phon441199/vehicle-gimbal-arm/gimbalarm_hardware_teensypin.txt

gm4108
 mks Dual channel FOC V3.2 Plus: ch1-0 1 2 +3(enable)/ch2-4 5 6+7(enable)/current	sensor1-14 15(analogue)/current sensor2-16 17

 encoder(AS5048A*2)1-9 + 11 12 13/encoder2-10(SPI) + 11 12 13(공통)

ak40 - 10
 CAN transciever(sn65hvd230)- 22(tx) 23(rx)

digital servo
 pwm-8
 
ICM20948(9축IMU)-18(sda) 19(scl)

  GM4108H + MKS DUAL FOC V3.2 Plus + Teensy 4.1 배선 가이드       
                                                                  
  1. GM4108H 모터 → MKS 보드 (모터 스크류 터미널)                 
                                                        
  MKS DUAL FOC 보드에는 M0, M1 두 개의 3상 모터 커넥터(스크류     
  터미널)가 있습니다.                                             
                                                                  
  ┌───────────┬──────────────┬────────────────────────────────┐   
  │   모터    │  MKS 터미널  │              연결              │
  ├───────────┼──────────────┼────────────────────────────────┤   
  │ GM4108H   │ M0 스크류    │ 모터의 3개 상선(A, B, C)을     │
  │ #1        │ 터미널       │ M0의 3핀에 연결                │
  ├───────────┼──────────────┼────────────────────────────────┤   
  │ GM4108H   │ M1 스크류    │ 모터의 3개 상선(A, B, C)을     │
  │ #2        │ 터미널       │ M1의 3핀에 연결                │   
  └───────────┴──────────────┴────────────────────────────────┘
                                                                  
  ▎ 상선 순서(A/B/C)가 바뀌면 모터 회전 방향만 바뀝니다. SimpleFOC
  ▎  initFOC()가 자동 정렬하므로 크게 문제없지만, 일관성 있게 
  ▎ 연결하는 것이 좋습니다.                                       
                                                        
  ---
  2. MKS 보드 ESP32 소켓 헤더 → Teensy 4.1
                                                                  
  MKS 보드는 원래 ESP32 모듈을 꽂는 상단/하단 2열 13핀 헤더가
  있습니다. ESP32 대신 Teensy 4.1에서 점퍼선으로 연결합니다.      
                                                        
  상단 헤더 (13핀, 왼→오로 번호 매김)                             
                                                        
  핀번호:  1    2    3     4     5     6     7     8     9      10
      11   12     13                                              
  기능:   GND   -   PhC1  PhB1  PhA1  PhC0  PhB0  PhA0  Cur1A
  Cur1B  -   Cur0A  Cur0B                                         
                                                        
  하단 헤더 (13핀, 왼→오)                                         
                                                        
  핀번호:  1    2    3-5   6    7    8     9     10    11    12   
  13                                                              
  기능:   EN1  EN0   -    RX   TX   SCL1  SCL0  SDA1  SDA0   -
  3.3V                                                            
                                                        
  ---                                                             
  3. 실제 배선표 (Teensy 핀 → MKS 헤더 핀)              
                                                                  
  모터 0 (펌웨어의 motor1, CH1) — PWM + Enable
                                                                  
  ┌───────────┬─────┬─────────────────┬────────────┐              
  │ Teensy 핀 │  →  │  MKS 헤더 위치  │    기능    │              
  ├───────────┼─────┼─────────────────┼────────────┤              
  │ Pin 0     │ →   │ 상단 8번 (PhA0) │ M0 A상 PWM │    
  ├───────────┼─────┼─────────────────┼────────────┤
  │ Pin 1     │ →   │ 상단 7번 (PhB0) │ M0 B상 PWM │              
  ├───────────┼─────┼─────────────────┼────────────┤              
  │ Pin 2     │ →   │ 상단 6번 (PhC0) │ M0 C상 PWM │              
  ├───────────┼─────┼─────────────────┼────────────┤              
  │ Pin 3     │ →   │ 하단 2번 (EN0)  │ M0 Enable  │    
  └───────────┴─────┴─────────────────┴────────────┘              
   
  모터 1 (펌웨어의 motor2, CH2) — PWM + Enable                    
                                                        
  ┌───────────┬─────┬─────────────────┬────────────┐              
  │ Teensy 핀 │  →  │  MKS 헤더 위치  │    기능    │
  ├───────────┼─────┼─────────────────┼────────────┤              
  │ Pin 4     │ →   │ 상단 5번 (PhA1) │ M1 A상 PWM │    
  ├───────────┼─────┼─────────────────┼────────────┤
  │ Pin 5     │ →   │ 상단 4번 (PhB1) │ M1 B상 PWM │
  ├───────────┼─────┼─────────────────┼────────────┤              
  │ Pin 6     │ →   │ 상단 3번 (PhC1) │ M1 C상 PWM │
  ├───────────┼─────┼─────────────────┼────────────┤              
  │ Pin 7     │ →   │ 하단 1번 (EN1)  │ M1 Enable  │    
  └───────────┴─────┴─────────────────┴────────────┘              
   
  전류센서 (아날로그 입력)                                        
                                                        
  ┌────────────────┬─────┬───────────────────┬─────────────┐      
  │   Teensy 핀    │  →  │   MKS 헤더 위치   │    기능     │
  ├────────────────┼─────┼───────────────────┼─────────────┤      
  │ A0 (물리핀 14) │ →   │ 상단 12번 (Cur0A) │ M0 A상 전류 │
  ├────────────────┼─────┼───────────────────┼─────────────┤
  │ A1 (물리핀 15) │ →   │ 상단 13번 (Cur0B) │ M0 B상 전류 │      
  ├────────────────┼─────┼───────────────────┼─────────────┤      
  │ A2 (물리핀 16) │ →   │ 상단 9번 (Cur1A)  │ M1 A상 전류 │      
  ├────────────────┼─────┼───────────────────┼─────────────┤      
  │ A3 (물리핀 17) │ →   │ 상단 10번 (Cur1B) │ M1 B상 전류 │
  └────────────────┴─────┴───────────────────┴─────────────┘      
                                                        
  GND (필수!)                                                     
   
  ┌──────────┬─────┬─────────────┬────────────────────────────┐   
  │ Teensy   │  →  │  MKS 헤더   │            비고            │
  │    핀    │     │    위치     │                            │   
  ├──────────┼─────┼─────────────┼────────────────────────────┤
  │ GND      │ →   │ 상단 1번    │ Teensy와 MKS 보드의        │   
  │          │     │ (GND)       │ 기준전압 통일              │   
  └──────────┴─────┴─────────────┴────────────────────────────┘
                                                                  
  ---                                                   
  4. 엔코더 AS5048A (SPI) — MKS 보드 아님, 별도 연결
                                                                  
  엔코더는 MKS 보드를 거치지 않고 Teensy에 직접 연결합니다.
                                                                  
  ┌───────────────┬─────┬────────────────┬───────────┐            
  │   Teensy 핀   │  →  │    AS5048A     │   비고    │            
  ├───────────────┼─────┼────────────────┼───────────┤            
  │ Pin 11 (MOSI) │ →   │ 두 엔코더 MOSI │ SPI0 공유 │  
  ├───────────────┼─────┼────────────────┼───────────┤
  │ Pin 12 (MISO) │ →   │ 두 엔코더 MISO │ SPI0 공유 │            
  ├───────────────┼─────┼────────────────┼───────────┤            
  │ Pin 13 (SCK)  │ →   │ 두 엔코더 CLK  │ SPI0 공유 │            
  ├───────────────┼─────┼────────────────┼───────────┤            
  │ Pin 9         │ →   │ 엔코더 #1 CS   │ 칩셀렉트  │  
  ├───────────────┼─────┼────────────────┼───────────┤            
  │ Pin 10        │ →   │ 엔코더 #2 CS   │ 칩셀렉트  │  
  ├───────────────┼─────┼────────────────┼───────────┤            
  │ 3.3V          │ →   │ 두 엔코더 VDD  │           │  
  ├───────────────┼─────┼────────────────┼───────────┤            
  │ GND           │ →   │ 두 엔코더 GND  │           │
  └───────────────┴─────┴────────────────┴───────────┘            
                                                        
  ---
  5. IMU ICM20948 (I2C) — 별도 연결
                                                                  
  ┌──────────────┬─────┬──────────┬───────────────┐
  │  Teensy 핀   │  →  │ ICM20948 │     비고      │               
  ├──────────────┼─────┼──────────┼───────────────┤     
  │ Pin 18 (SDA) │ →   │ SDA      │ Wire 기본 I2C │               
  ├──────────────┼─────┼──────────┼───────────────┤     
  │ Pin 19 (SCL) │ →   │ SCL      │               │               
  ├──────────────┼─────┼──────────┼───────────────┤
  │ 3.3V         │ →   │ VDD      │               │               
  ├──────────────┼─────┼──────────┼───────────────┤     
  │ GND          │ →   │ GND      │               │
  └──────────────┴─────┴──────────┴───────────────┘               
   
  ---                                                             
  6. 전원                                               
         
  ┌──────────────────────┬────────────────────────────────────┐
  │         연결         │                비고                │   
  ├──────────────────────┼────────────────────────────────────┤
  │ 12V DC → MKS 보드    │ 모터 구동 전원 (SUPPLY_VOLTAGE =   │   
  │ 전원 입력            │ 12.0V)                             │
  ├──────────────────────┼────────────────────────────────────┤   
  │ Teensy는 USB로 별도  │ 또는 Vin에 12V 가능 (Teensy 내부   │
  │ 전원                 │ 레귤레이터)                        │   
  └──────────────────────┴────────────────────────────────────┘
                                                                  
  ---                                                   
  주의사항
          
  1. GND 반드시 공유 — Teensy GND와 MKS 보드 GND(상단 1번)를
  연결하지 않으면 PWM 신호 기준이 틀어져 모터가 동작하지 않습니다 
  2. 전류센서 gain 반전 — 펌웨어에서 gain_a *= -1; gain_b *= -1;
  처리 이미 되어 있음 (MKS 보드 INA181A2 특성)                    
  3. 상선 순서 — GM4108H 모터의 3선 색상이 제조사마다 다를 수
  있으므로, 연결 후 initFOC()에서 방향 확인 필요. 반대로 돌면 두  
  선만 교체                                             
  4. ESP32 모듈 분리 — MKS 보드에 ESP32가 꽂혀있다면 반드시 빼고  
  Teensy 연결 (두 MCU가 동시에 핀을 드라이브하면 보드 손상 가능)  
   
● 이 질문은 코드 변경이 아닌 하드웨어 배선 설명 요청이므로, 위에  
  정리한 내용이 답변의 전부입니다. 추가로 궁금한 점이 있으면
  말씀해주세요.
