phon441199/vehicle-gimbal-arm/src/shaker_firmware/control_structure.docx

# 이중 서보 조화가진장치 — IMU 기반 위상동기 제어 구조

작성: 제어구조 정리 (블록다이어그램 작도용)

# 1. 시스템 개요 & 목표

연속회전 서보 2개가 크랭크-슬라이더로 30×30 cm 판을 상하 가진(≈ 2 Hz)한다.

두 가지 목표를 동시에 달성:

1. 수직 조화가진 z̈ 생성 (장치의 목적 기능)
2. 판의 롤 θ(기울기)를 0으로 유지 (두 서보 위상 드리프트로 판이 점점 기울어지는 문제 보정)

# 2. 핵심 물리 — 두 운동이 분리되어 한 구조에 공존

두 크랭크 각도 φ₁, φ₂에 대해 판의 두 운동은 공통모드/차동모드로 분리된다:

운동 | 결정 요인 | 성격
수직 가진 z | φ₁ + φ₂ (공통/합) | 만들고 싶은 출력 → u₀로 구동 (개루프)
롤 θ | φ₁ − φ₂ (차동/차) | 0으로 없애고 싶은 것 → 피드백으로 규제

핵심: 위상차(Δ)를 조절해 롤을 잡아도 두 크랭크의 평균 회전(=수직 가진)은 그대로 유지된다 → 서로 간섭 없이 한 구조에 공존한다.

# 3. 플랜트 (입력 2 / 출력 2)

플랜트 = [서보 2개 + 크랭크-슬라이더 + 판] 한 블록

입력:

- u₀ (BASE_OFFSET): 두 서보 공통 기준 구동속도. 가진을 만드는 구동력 (외부 설정값, 조작변수 아님).
- Δ: 슬레이브 서보 속도 보정 = 유일한 조작변수. 마스터=u₀ 고정, 슬레이브 명령=u₀+Δ.

출력:

- z̈: 수직 조화가진(≈2 Hz) — 목적 출력, 피드백 안 함 (개루프).
- θ: 판의 롤 — 규제 대상, 피드백 함 (폐루프).

# 4. 순방향 경로 (forward path)

3. 기준입력: θ_ref = 0 (판 수평이 목표)
4. 비교기 (합산점 ⊗): e = θ_ref − θ_meas. 피드백은 음(−)으로 입력.
5. PI 제어기 (병렬 2블록 → 합산점에서 합): 비례항 K_p·e, 적분항 K_i∫e dt (위상 드리프트 제거의 핵심), 합산점(+/+) → 보정량 Δ 출력.
6. Δ → 플랜트 (슬레이브 속도 보정으로 인가).
7. 플랜트가 z̈(가진 출력)와 θ(롤)를 동시에 생성.

# 5. 피드백 경로 (feedback path) — 상관검파로 롤/위상오차 측정

8. IMU (MPU-6500): 자이로 ω_roll(롤 각속도) + 가속도계 a_z(수직 가속도) 측정.
9. High-pass 필터: 중력/DC 제거 → 교류 성분 ω̃_roll, ã_z.
10. 곱셈기 (×): ω̃_roll · ã_z (순간 상관).
11. Low-pass 필터 ⟨·⟩: 시간 평균 → ⟨ω̃_roll · ã_z⟩ ∝ sin(Δφ) ≈ 위상오차/롤.
12. 이 값을 비교기(−)로 환류 → 루프 폐합.

원리: 두 크랭크가 동기되면 판이 수평 유지하며 상하로만 움직여 롤≈0. 어긋나면 롤이 생기고 ⟨롤각속도×수직가속도⟩의 평균이 sin(위상차)에 비례 → 드라이브 주파수를 몰라도 오차의 크기·부호 추출(동기검파). PI 적분기가 이 오차를 0으로 몰아 슬레이브 평균속도를 마스터에 맞춘다.

# 6. 블록 배치 (그릴 때 순서)

순방향 (위, 좌→우):

[theta_ref=0] -> (+/-)O -> e -> [ K_p ] \
(+/+)O -> Delta -> [ Plant: 2서보+크랭크+판 ] -> z.. 가진출력(~2Hz)
e -> [ K_i∫dt ] / ^ |
u0(BASE_OFFSET) theta(롤)

피드백 (아래, 우→좌):

theta -> [IMU: w_roll, a_z] -> [High-pass] -> [ x 곱셈 ] -> [Low-pass <.>] -> (-)O 로 환류

블록 색 구분(권장): 흰색=기준입력, 주황=게인(K_p,K_i), 남색=처리(High-pass/×/Low-pass), 초록=센서(IMU), 하늘색=플랜트.

합산점 vs 곱셈기: 합산점 ⊗는 +/− 부호 표시, 곱셈기는 × 로 구분.

# 7. 실제 파라미터 (참고)

항목 | 값
기준속도 u₀ | 400 (정지펄스 1513 µs 기준 오프셋), 가진 ≈ 2 Hz
PI 게인 | K_p = 8, K_i = 40 (적분 위주 설계)
보정 범위 Δ | ±250 µs
IMU 축 | 수직가속 = accel Z, 롤레이트 = gyro Y (실측 확정)
센서 | MPU-6500 (I²C, 100 kHz)
서보 정지펄스 | 1513 µs (DS3345 데드밴드 1504~1522 중앙)
