phon441199/vehicle-gimbal-arm/src/shaker_firmware/block_diagram4.png

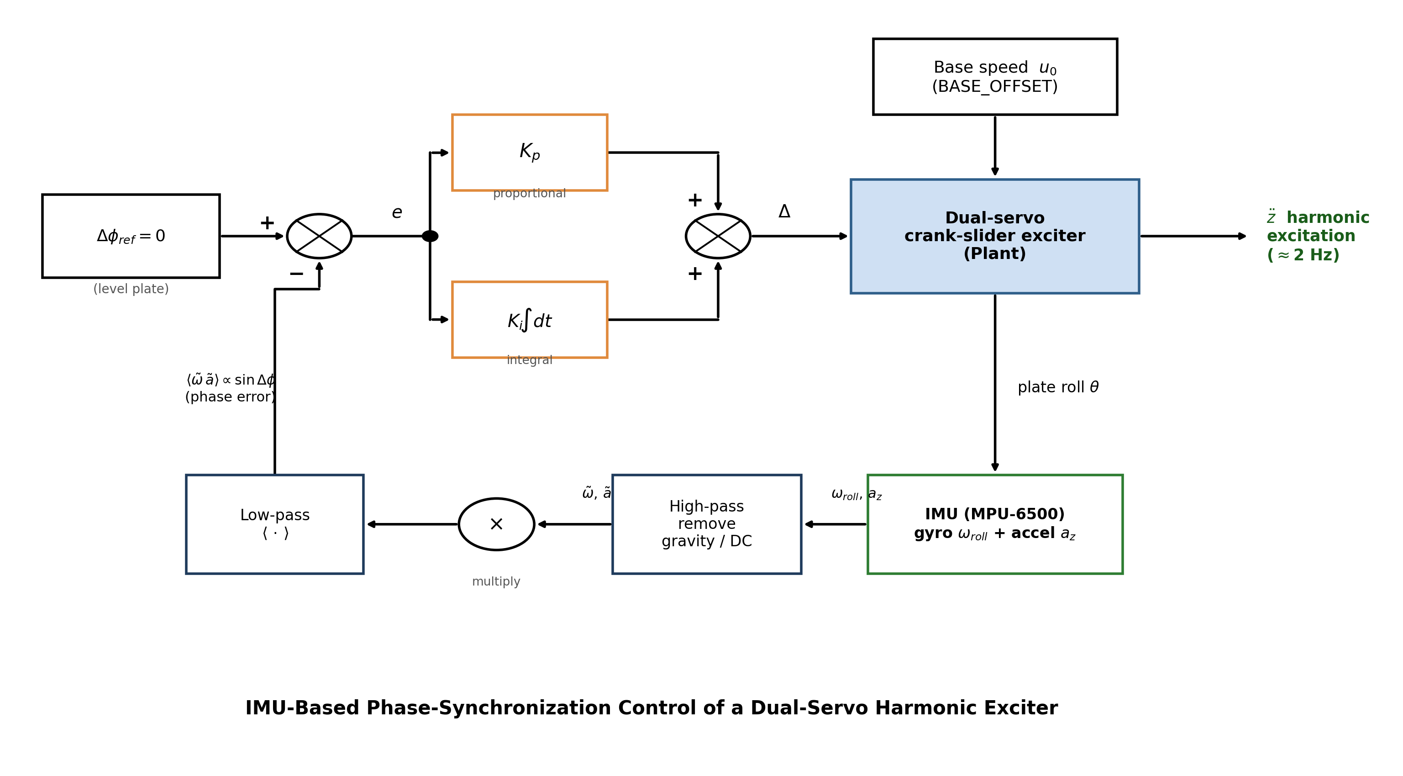
src/shaker_firmware/block_diagram4.png
