phon441199/vehicle-gimbal-arm/src/shaker_firmware/imu_freq_clean.png

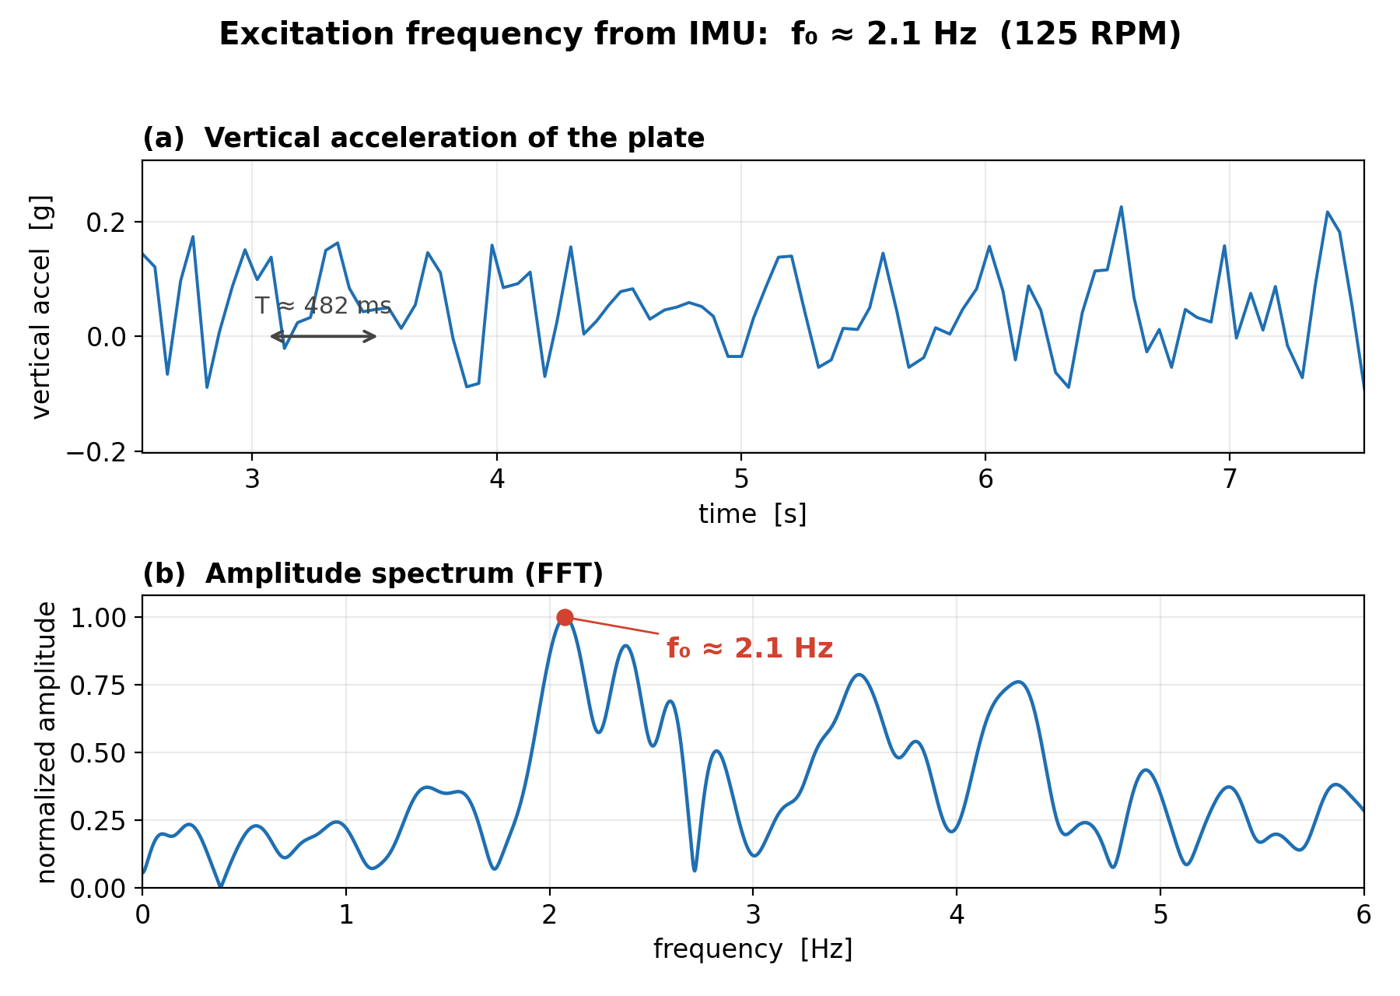
src/shaker_firmware/imu_freq_clean.png
