phon441199/vehicle-gimbal-arm/(commit log)

2026-08-24 Initial commit: vehicle-disturbance active vibration isolation robot arm
    5-axis arm (AK40-10 x2 CAN/MIT + GM4108 gimbal x2 SimpleFOC) with a
    two-layer control stack on top of the AK40's built-in MIT impedance loop:
    ESO-based disturbance rejection and task-space active suspension, bridged
    to ROS 2 via micro-ROS.
    - src/teensy_firmware: final integrated firmware, plus diagnostics/ and
    prototypes/ split out from the working sketch pile
    - src/esp32_firmware: pre-port stage (superseded by Teensy 4.1)
    - src/shaker_firmware: standalone excitation rig (PlatformIO)
    - src/gimbal_arm_controller, gimbalarm_description, gimbal_bridge,
    imu_test_visualizer: ROS 2 packages (kinematics, control, RViz, GU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
    [gimbalarm.urdf.xacro, imu_capture.csv]
2026-08-24 Correct control-structure framing to 2 layers and fix final-firmware label
    The README described a 3-layer stack that counted the AK40's built-in MIT
    impedance loop as layer 1. The portfolio's framing is a 2-layer structure:
    the commercial inner loop is used as-is, and two layers were implemented on
    top of it (ESO disturbance observer, task-space active suspension). Renumber
    accordingly and state explicitly why the inner loop is not counted.
    Also fixes a misclassification from the initial commit. arm_microros_teensy
    (1539 lines) is the actual final firmware -- it holds the suspension, ESO,
    micro-ROS reconnect, thermal trip, sector-snap homing and gravity structure --
    while gimbal_arm_full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
    [arm_microros_teensy.ino, gimbal_arm_full.ino]
2026-08-25 Use DOB terminology and describe the suspension as PD-based
    Aligns the READMEs with the portfolio write-up:
    - ESO -> DOB throughout. The firmware's own naming already carries both
    ("Level3 DOB", WR_DOB_KT alongside wr_eso_*), and DOB is the term the
    portfolio uses, so the docs now use it consistently.
    - The suspension is described as a PD-based variable suspension rather than
    task-space control: it is a proportional term on estimated tip displacement
    plus a sky-hook velocity term, with runtime-tunable gains and the MIT hold
    stiffness dropped 120 -> 30-40 when engaged. Calling it "task-space control"
    overstated the structure.
    - Tech stack list replaced with the portfolio's curr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
2026-08-25 ESP32 firmware was a mid-project debug board, not the initial platform
